BendeguzKincses/DIY-Moving-head-light/Pictures/IMG_20250401_113456.jpg

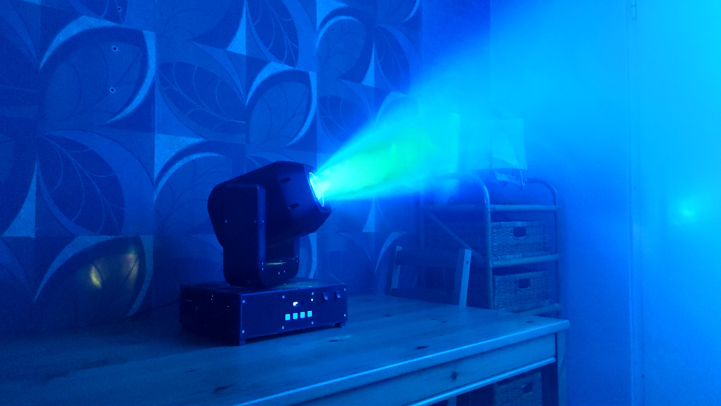
Pictures/IMG_20250401_113456.jpg
