BendeguzKincses/DIY-Moving-head-light/Pictures/IMG_20250401_113941.jpg

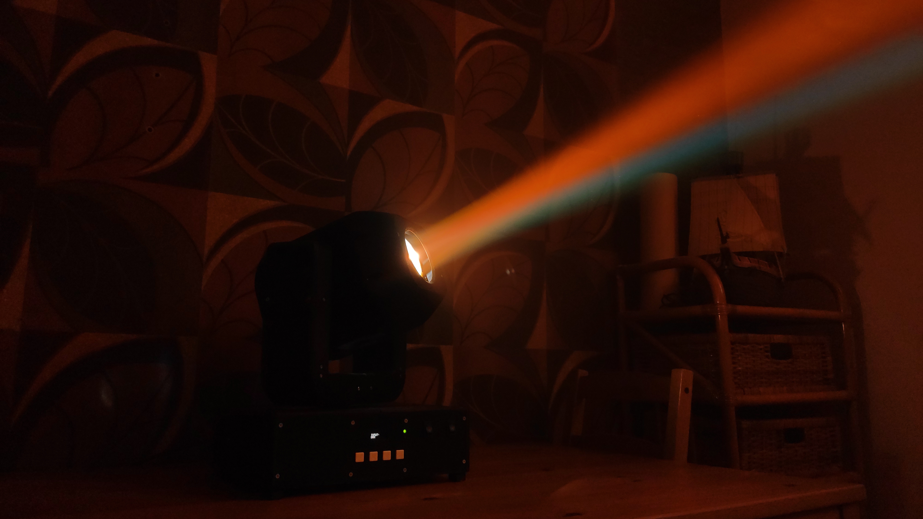
Pictures/IMG_20250401_113941.jpg
