BendeguzKincses/DIY-Moving-head-light/Pictures/IMG_20250401_142040.jpg

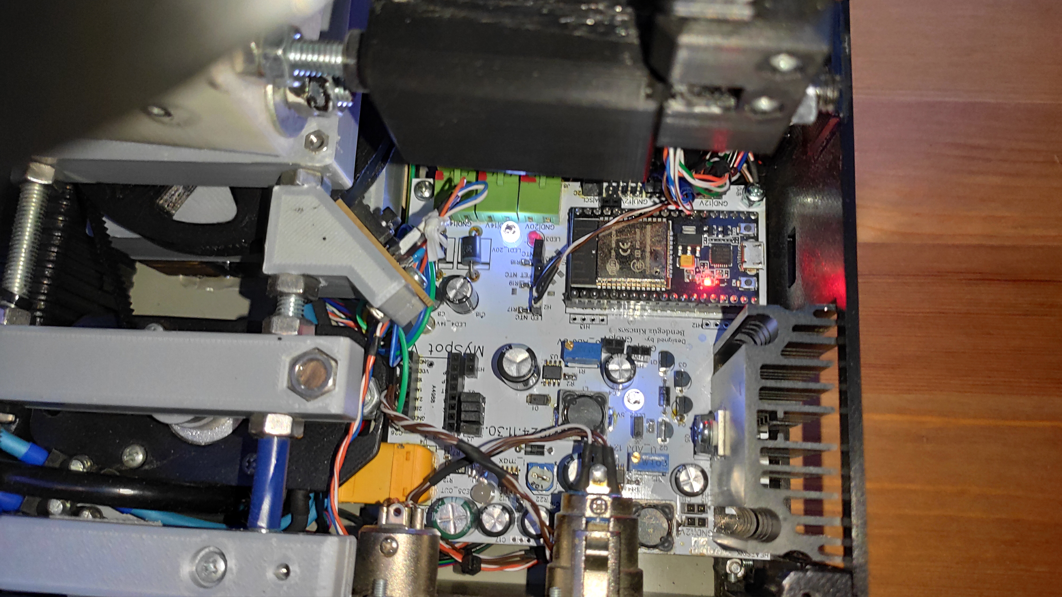
Pictures/IMG_20250401_142040.jpg
