BendeguzKincses/DIY-Moving-head-light/Pictures/MySpot_panel_beultetett_alkatreszekkel.jpg

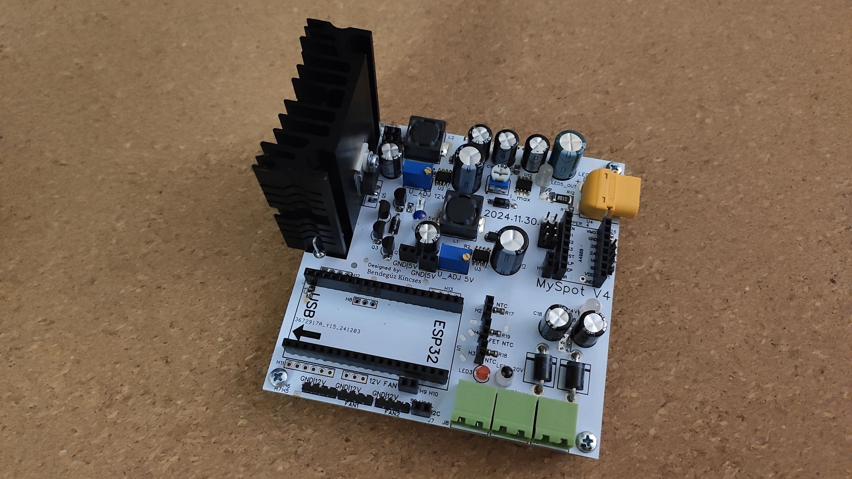
Pictures/MySpot_panel_beultetett_alkatreszekkel.jpg
