BendeguzKincses/DIY-Moving-head-light/Pictures/PCB_PCB_MySpotV4.png

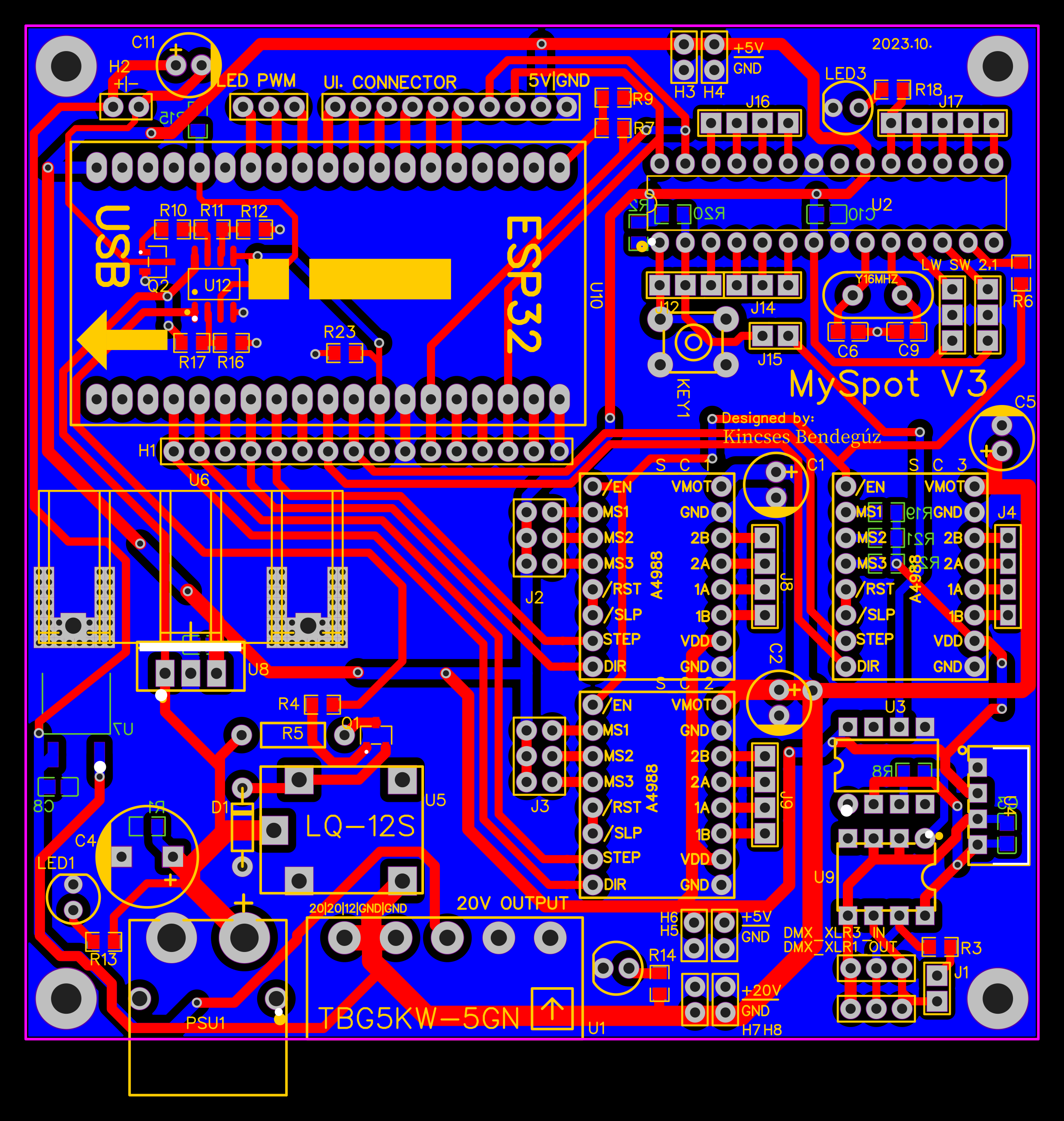
Pictures/PCB_PCB_MySpotV4.png
