BendeguzKincses/DIY-Moving-head-light/Schematic/Schematic_My_Spot_V3_2025-02-15.pdf

## Node MCU

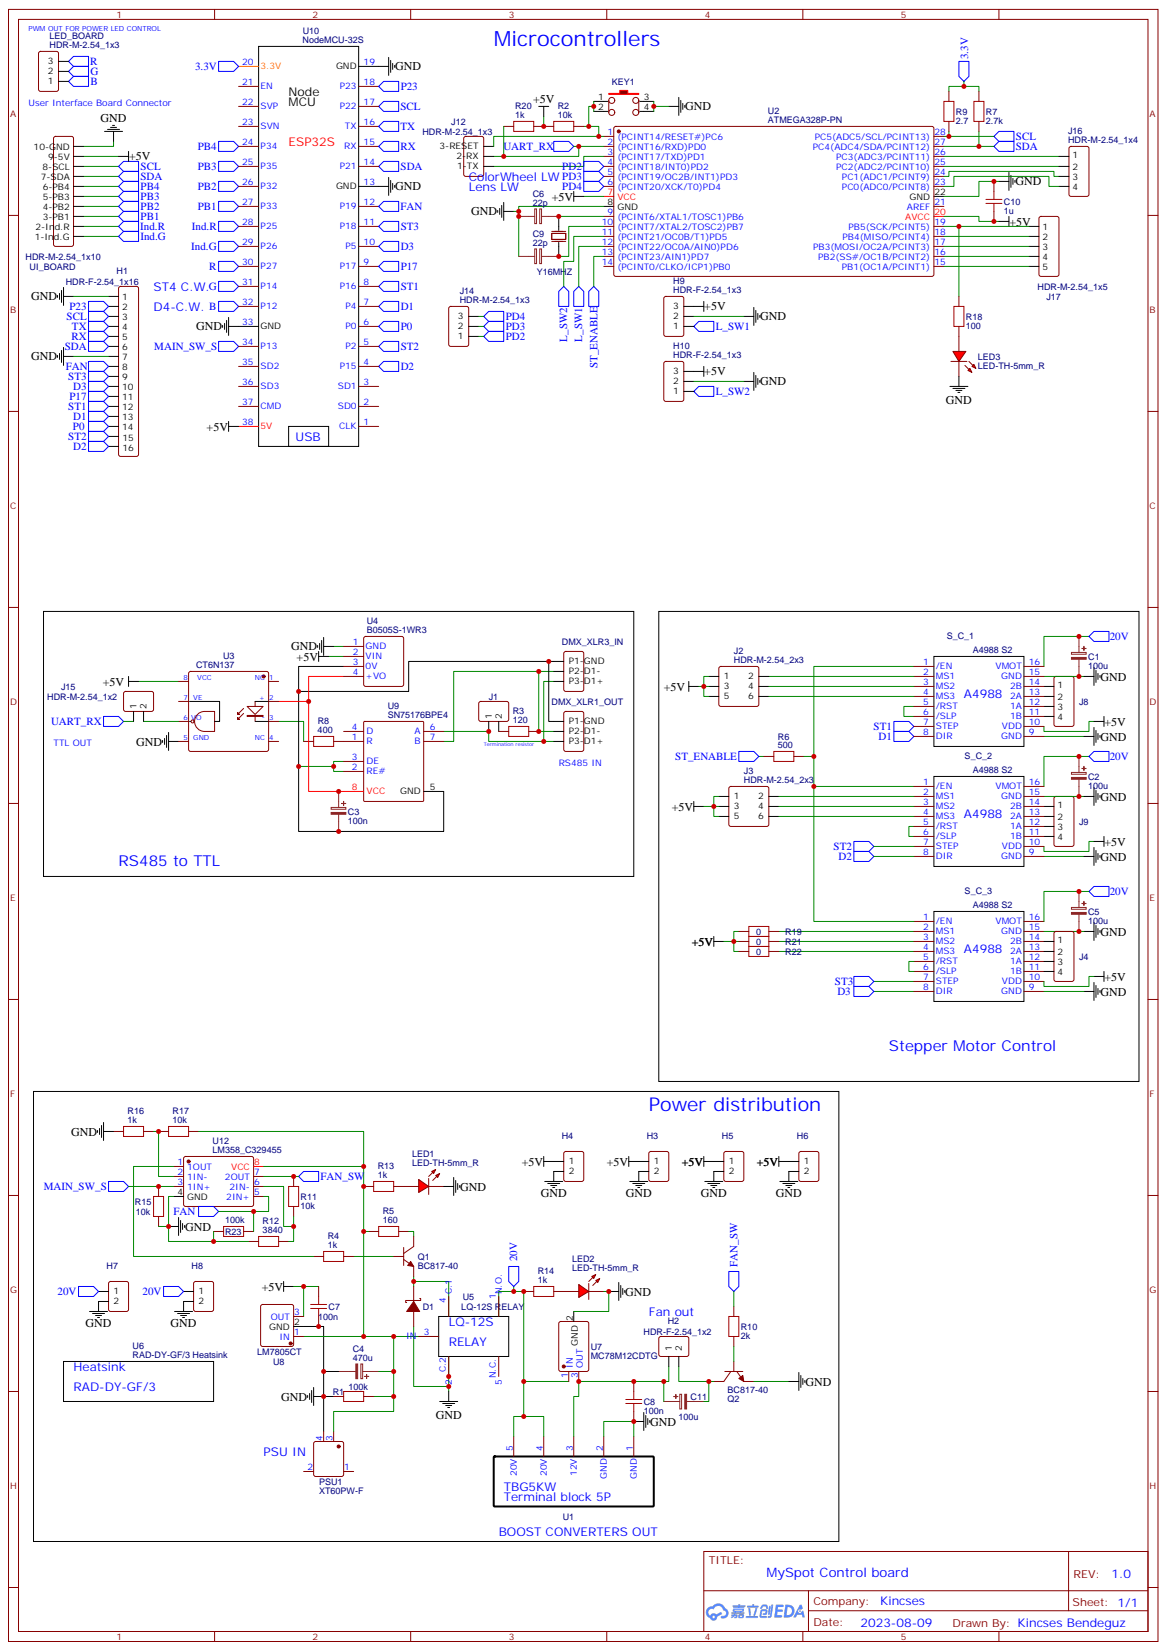
[picture p32: page 1]

User Interface Board Connector

RAD-DY-GF/3 Heatsink

Drawn By: Kincses Bendeguz
