BendeguzKincses/DIY-Moving-head-light/Schematic/Schematic_My_Spot_V4_2025-02-17 Portrait.pdf

## NTC1

## NTC2

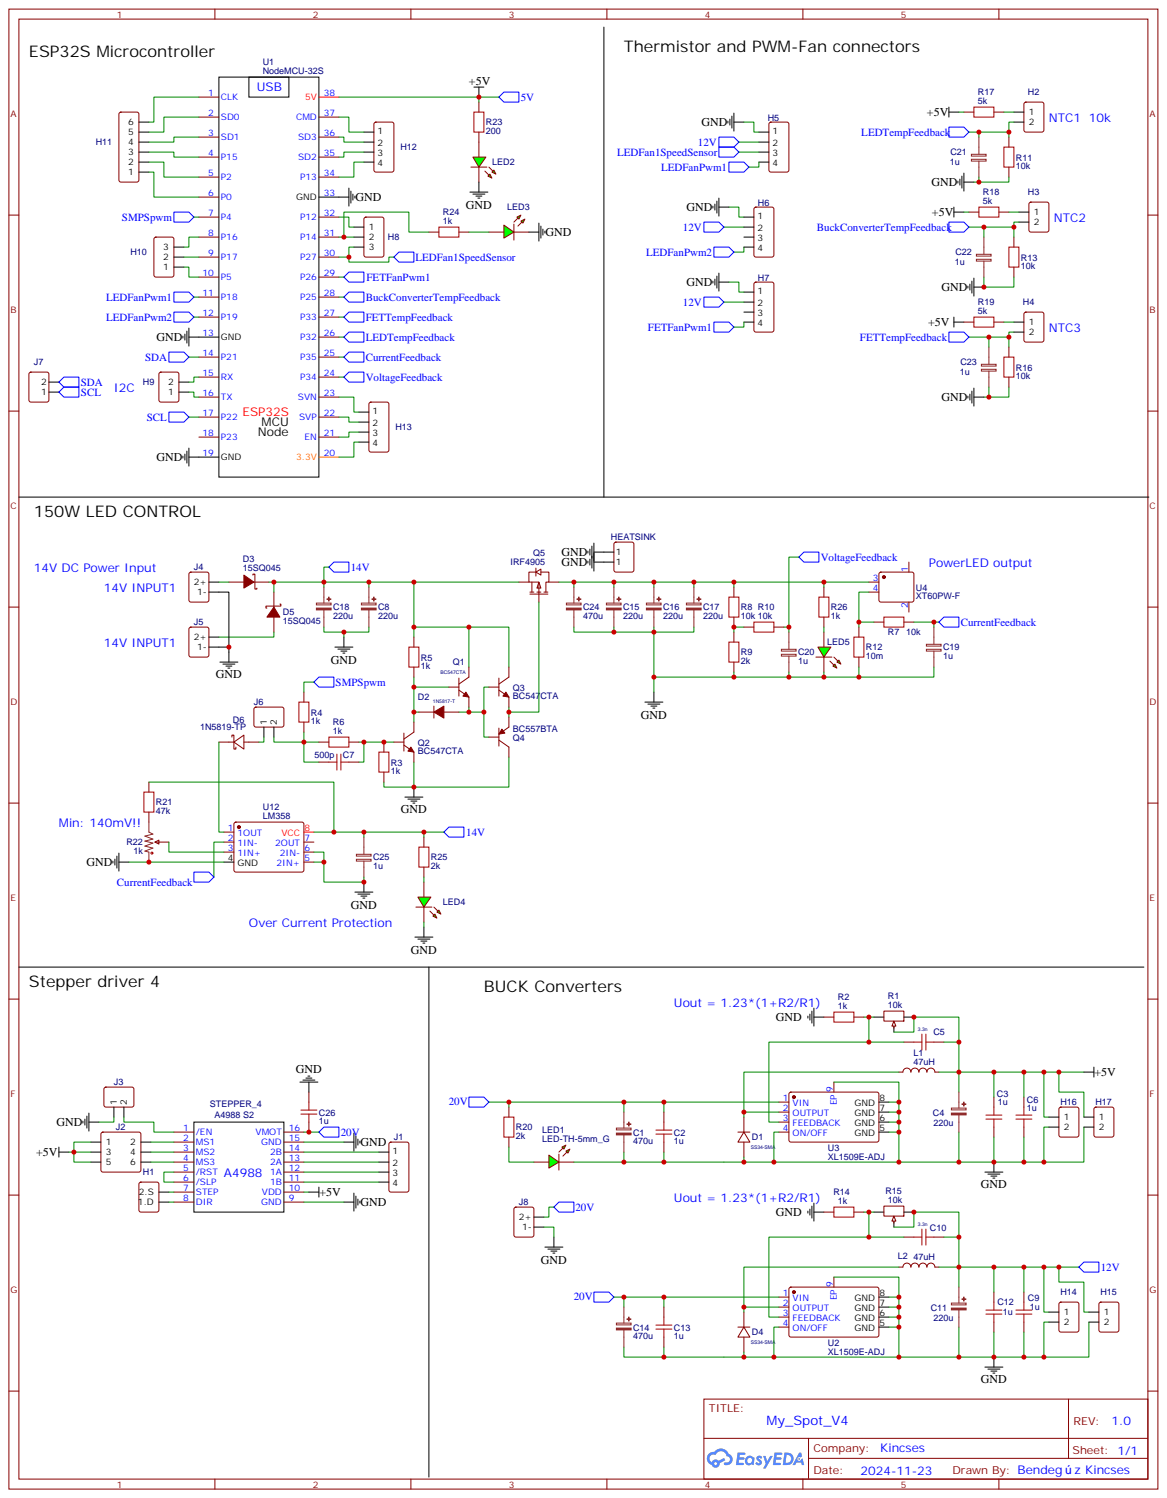
[picture p33: page 1]

PowerLED output 14V DC Power Input

Drawn By: Bendeg z Kincses
