BendeguzKincses/DIY-Moving-head-light/Schematic/Schematic_My_Spot_User_Interface_2025-02-20.pdf

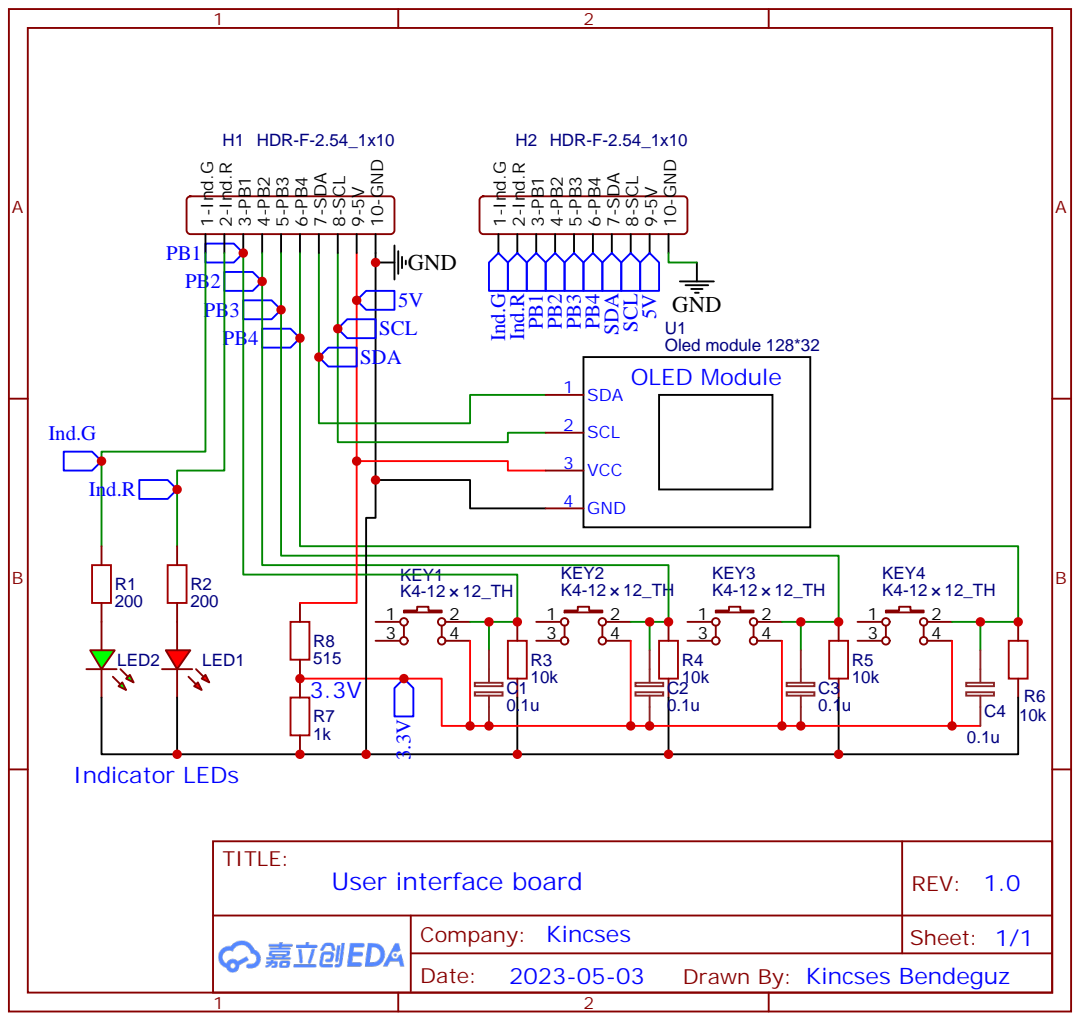
[picture p34: page 1]

Drawn By: Kincses Bendeguz
