BendeguzKincses/DIY-Moving-head-light/Schematic/Schematic_MySpot-Limit-Switch_2025-02-20.pdf

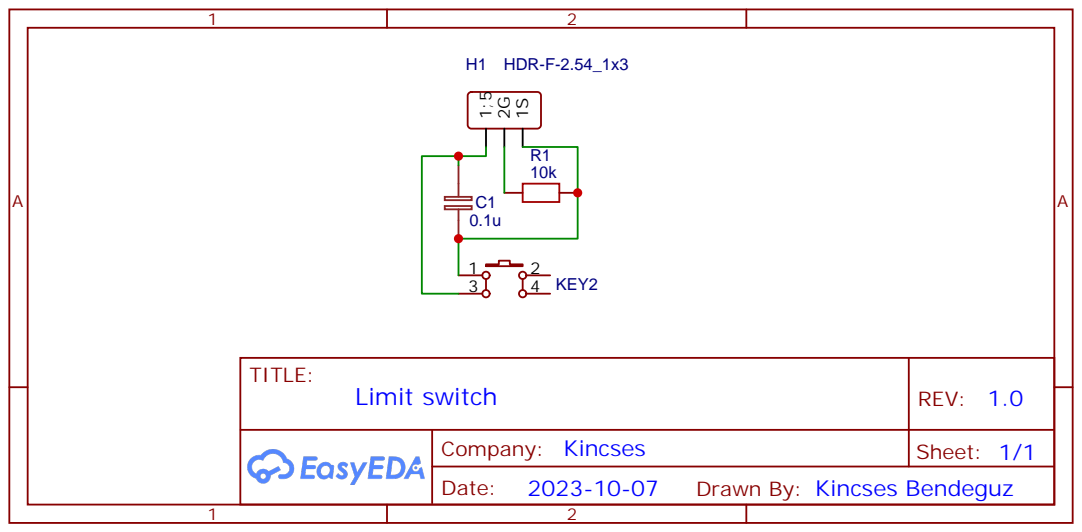
[picture p35: page 1]

Drawn By: Kincses Bendeguz
