BendeguzKincses/DIY-Moving-head-light/(list of files, drawings)

Other design files:
EasyEDA project directories/My_Spot_User_Interface/PCB_My_Spot_User_Interface.json
EasyEDA project directories/My_Spot_V3/PCB_My_Spot_V3 DIY Version.json
EasyEDA project directories/My_Spot_V3/PCB_My_Spot_V3 safety save 23.09.16. 2.json
EasyEDA project directories/My_Spot_V3/PCB_My_Spot_V3 safety save 23.09.16. 3.json
EasyEDA project directories/My_Spot_V3/PCB_My_Spot_V3 safety save 23.09.16.json
EasyEDA project directories/My_Spot_V3/PCB_My_Spot_V3 safety save 23.09.23.json
EasyEDA project directories/My_Spot_V3/PCB_My_Spot_V3.json
EasyEDA project directories/My_Spot_V4/PCB_My_Spot_V4 safety save 24.11.30.json
EasyEDA project directories/My_Spot_V4/PCB_My_Spot_V4.json
EasyEDA project directories/MySpot Limit Switch/PCB_MySpot Limit Switch.json
