BendeguzKincses/DIY-Moving-head-light/Pictures/34_OTIO_Poszter_Kincses_Bendeguz_email_nelkul.png

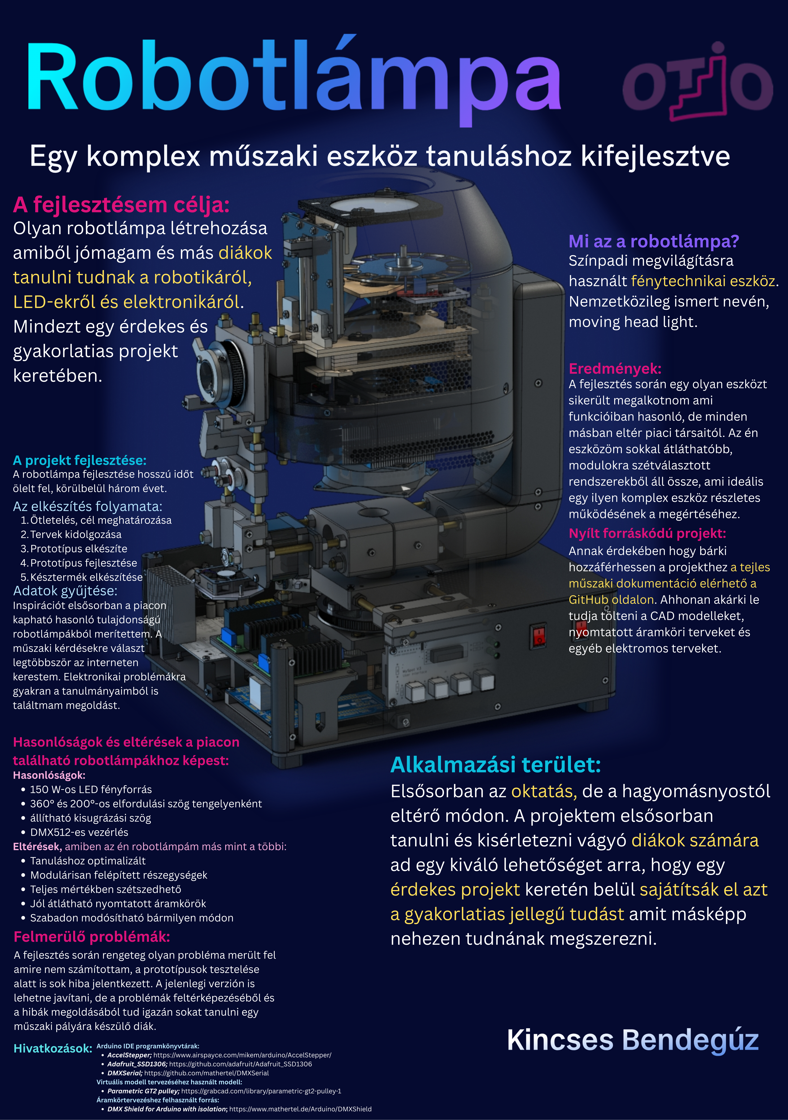
[picture p3: Pictures/34_OTIO_Poszter_Kincses_Bendeguz_email_nelkul.png]
Pictures/34_OTIO_Poszter_Kincses_Bendeguz_email_nelkul.png
